EdgarMata/MY-Filamente-Extruder/Eletronics.png

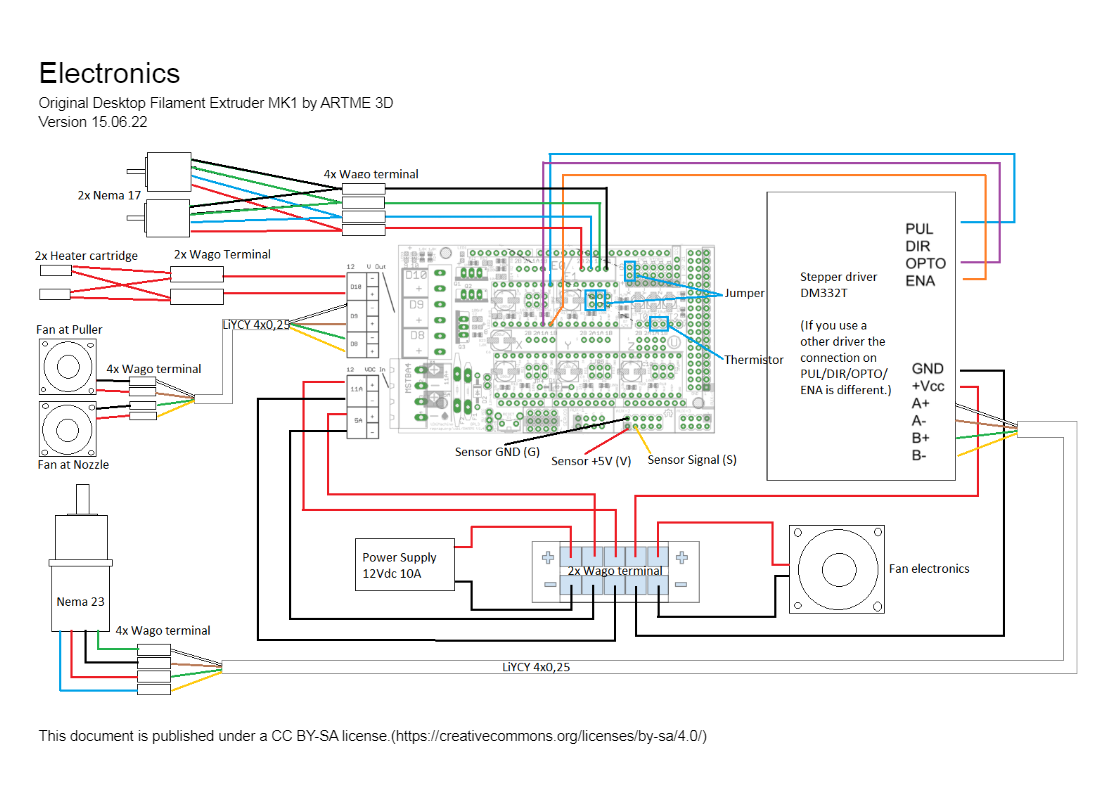
Eletronics.png
