EdgarMata/MY-Filamente-Extruder/Extruder Barrel.png

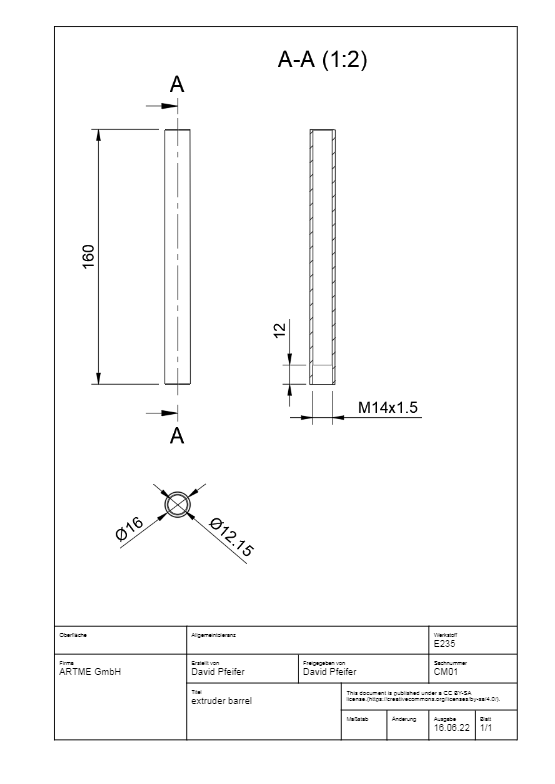
Extruder Barrel.png
