EdgarMata/MY-Filamente-Extruder/01-PartList.png

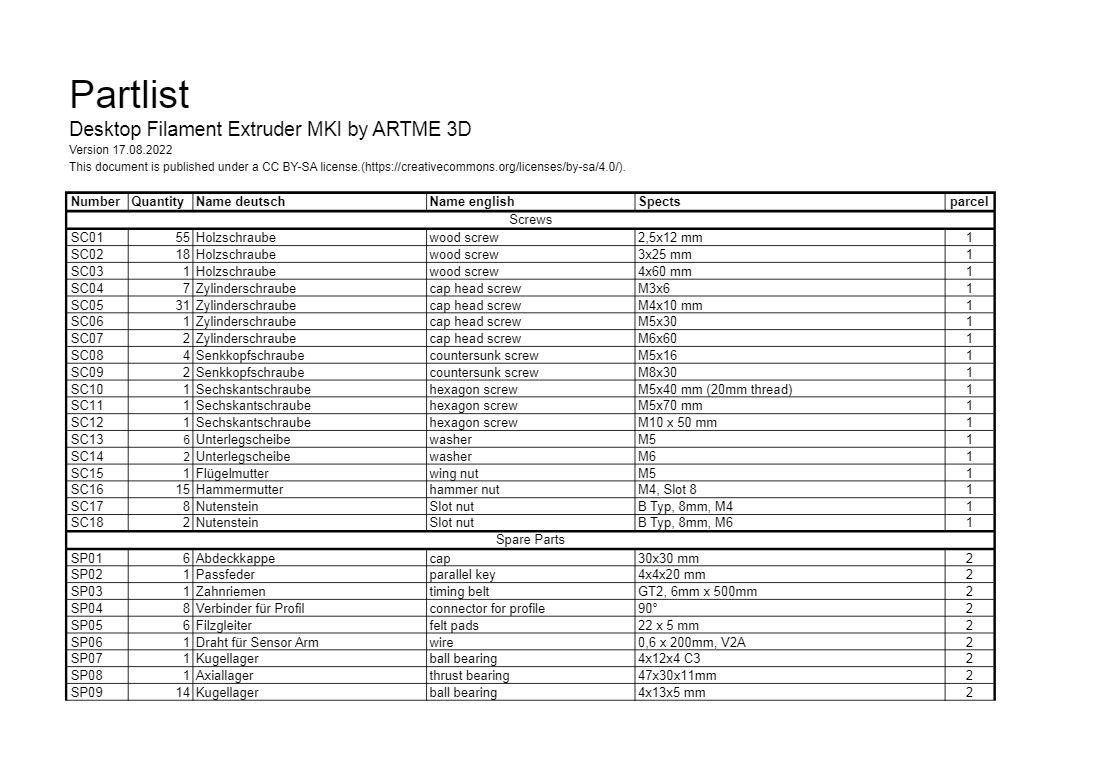
01-PartList.png
