EdgarMata/MY-Filamente-Extruder/02-PartList.png

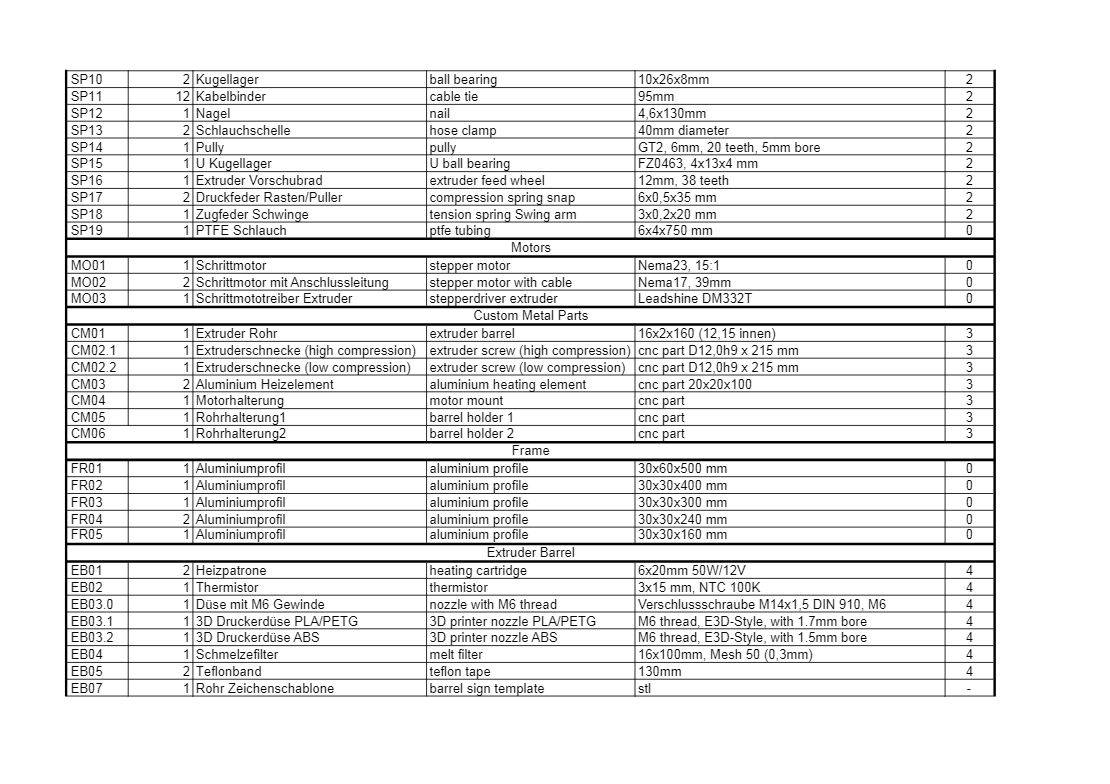
02-PartList.png
