EdgarMata/MY-Filamente-Extruder/03-PartList.png

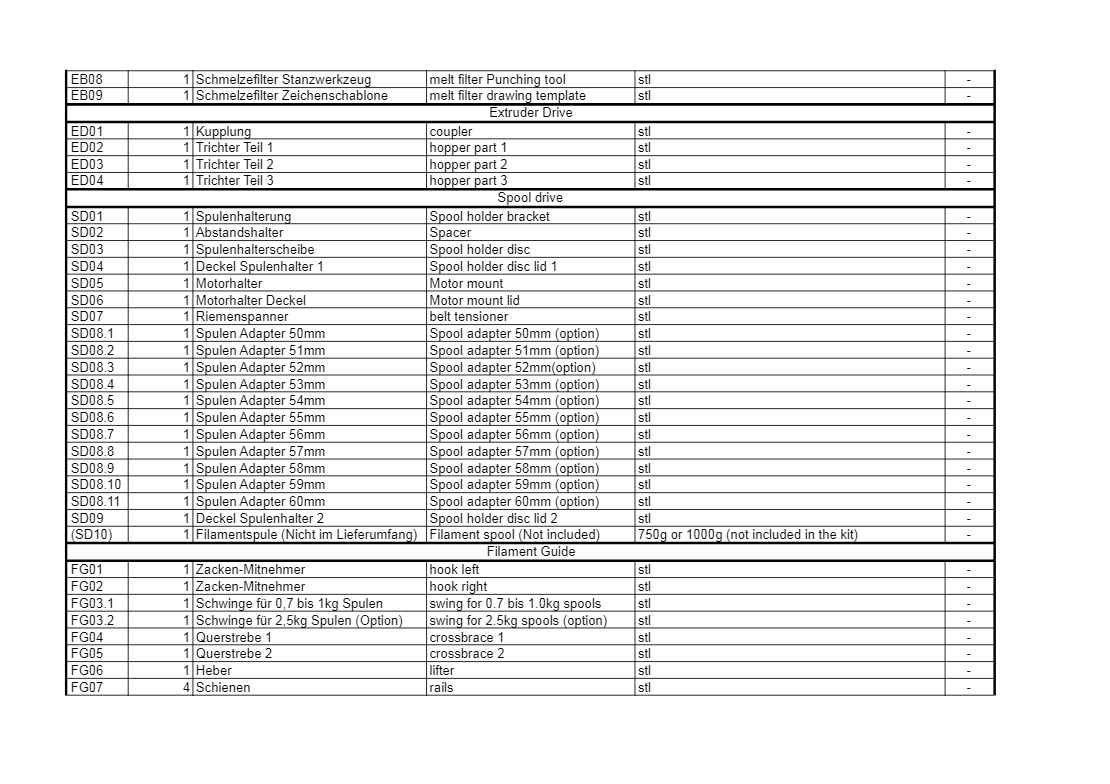
03-PartList.png
