EdgarMata/MY-Filamente-Extruder/04-PartList.png

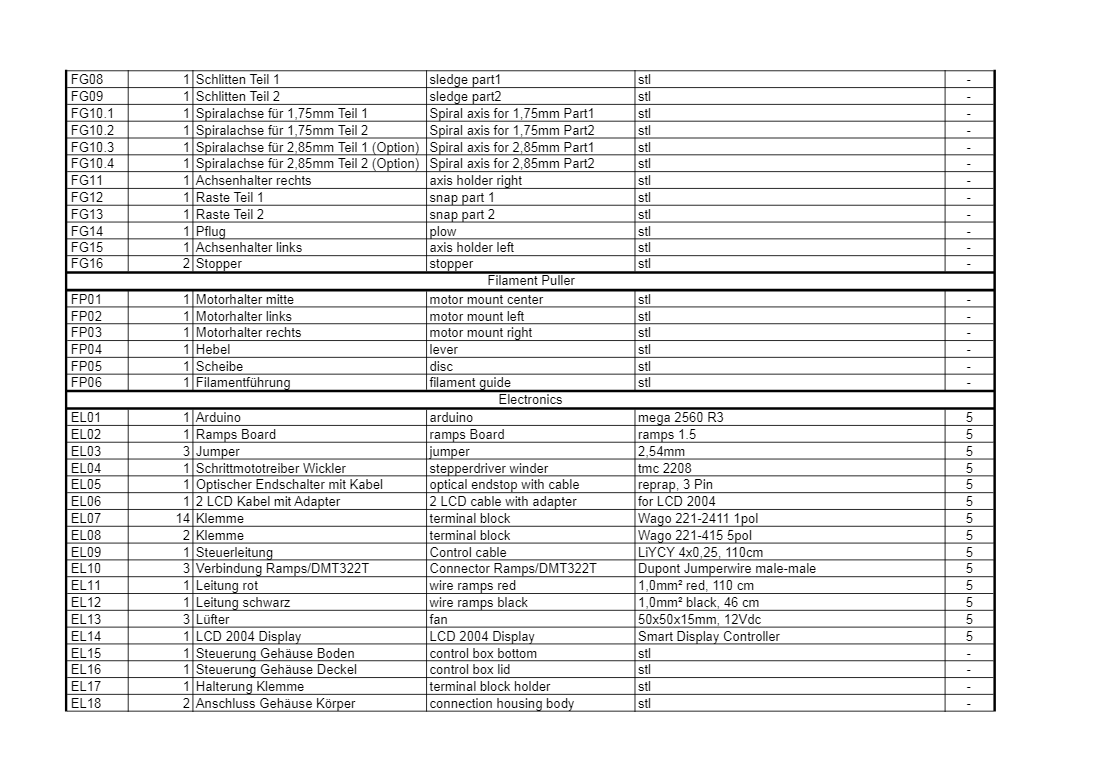
04-PartList.png
