EdgarMata/MY-Filamente-Extruder/05-PartList.png

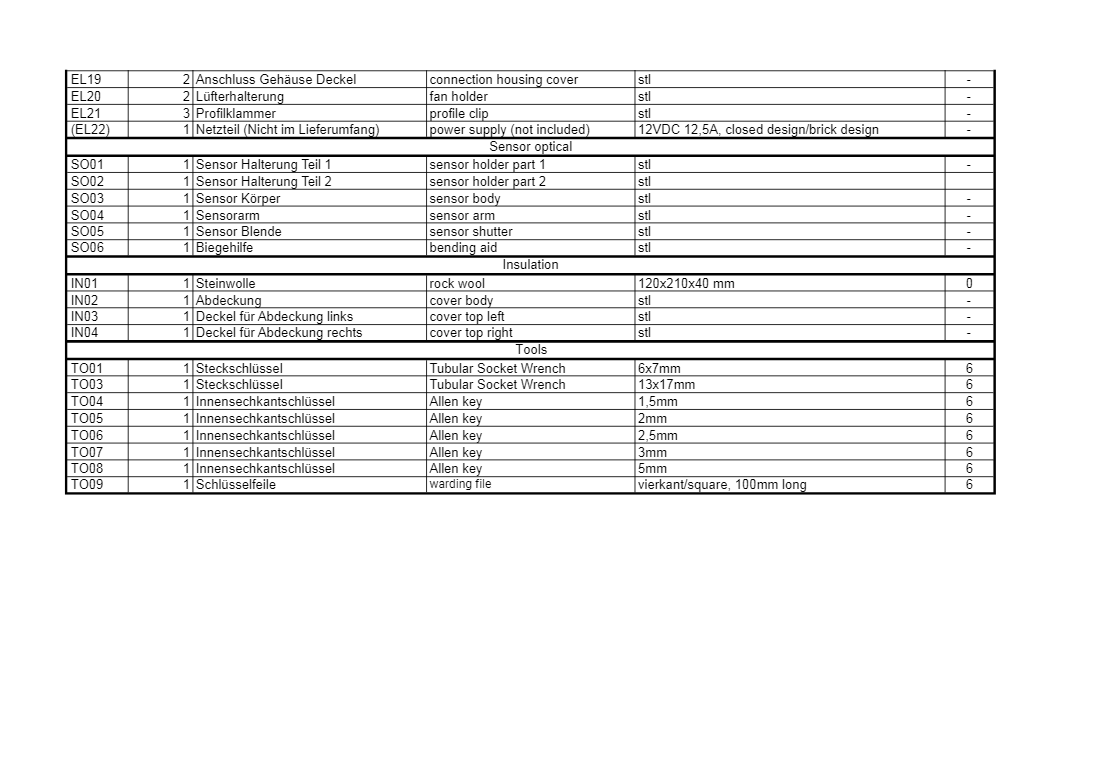
05-PartList.png
