EdgarMata/MY-Filamente-Extruder/05-STL-Dateien-MK1-22-10-26/Electronic (EL)/EL17_terminal block holder.stl

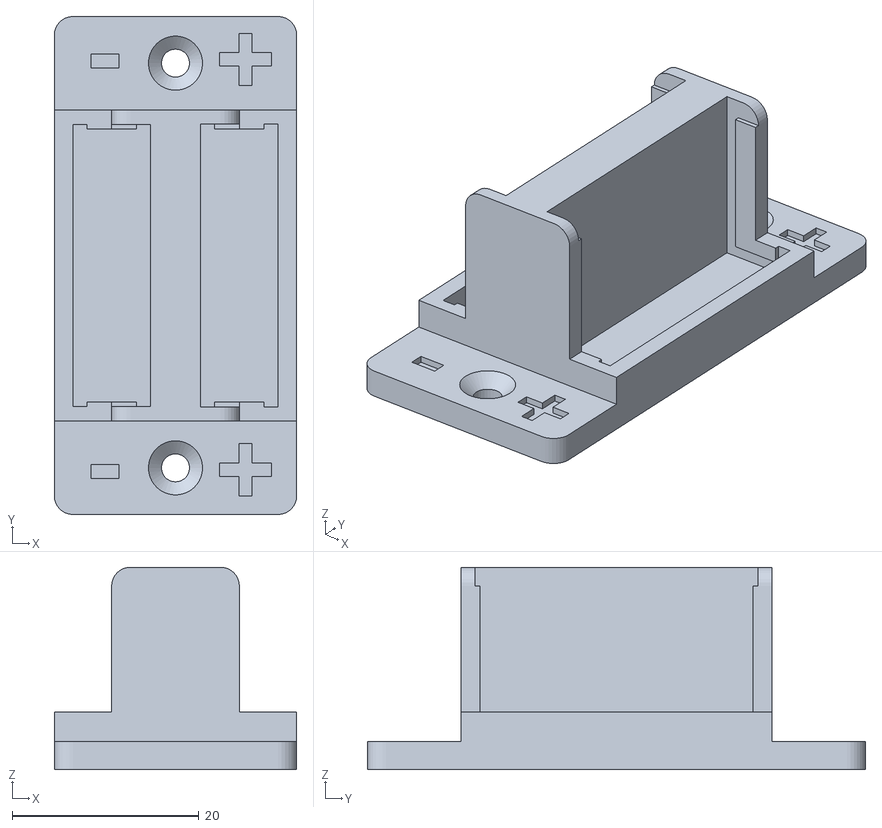
[picture p8: CAD file, 2024-07-03]
05-STL-Dateien-MK1-22-10-26/Electronic (EL)/EL17_terminal block holder.stl
26.0 x 53.4 x 21.7
