EdgarMata/MY-Filamente-Extruder/05-STL-Dateien-MK1-22-10-26/Extruder-Barrel (EB)/EB07-barrel sign template.stl

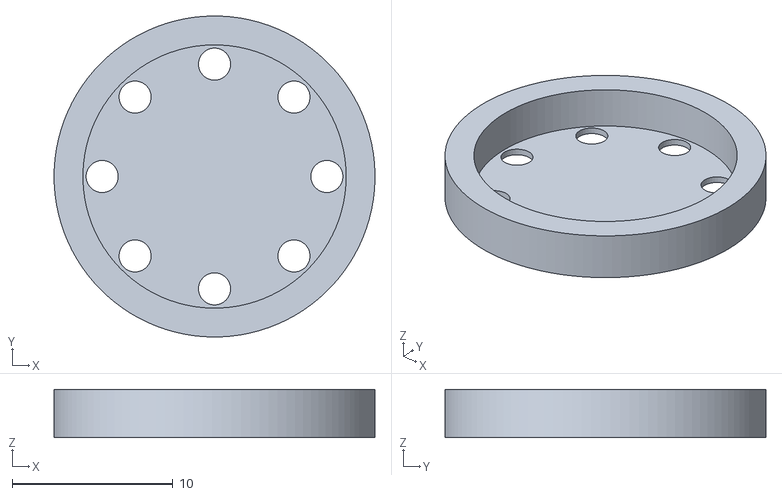
[picture p9: CAD file, 2024-07-03]
05-STL-Dateien-MK1-22-10-26/Extruder-Barrel (EB)/EB07-barrel sign template.stl
20.0 x 20.0 x 3.00
