EdgarMata/MY-Filamente-Extruder/05-STL-Dateien-MK1-22-10-26/Extruder-Drive (ED)/ED03-hopper part2.stl

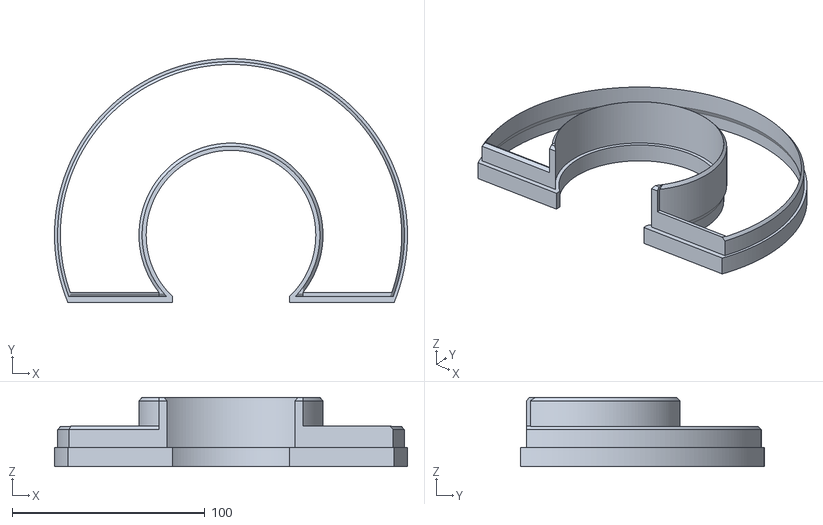
[picture p10: CAD file, 2024-07-03]
05-STL-Dateien-MK1-22-10-26/Extruder-Drive (ED)/ED03-hopper part2.stl
183.2 x 126.5 x 36.0
