EdgarMata/MY-Filamente-Extruder/05-STL-Dateien-MK1-22-10-26/Filament-Guide (FG)/FG09-sledge part2.stl

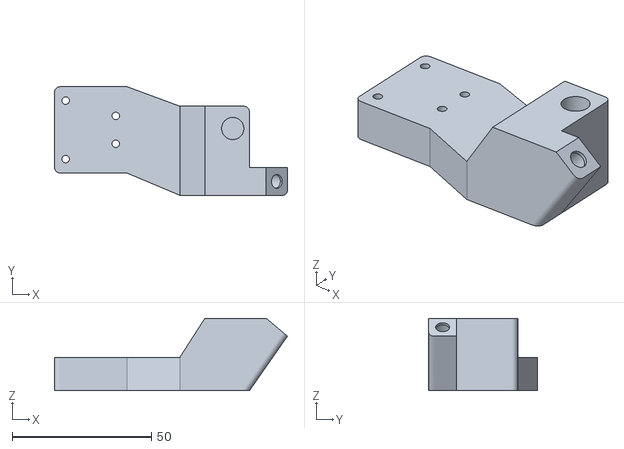
[picture p11: CAD file, 2024-07-03]
05-STL-Dateien-MK1-22-10-26/Filament-Guide (FG)/FG09-sledge part2.stl
83.7 x 39.0 x 26.0
