EdgarMata/MY-Filamente-Extruder/05-STL-Dateien-MK1-22-10-26/Filament-Puller (FP)/FP02-motor mount left.stl

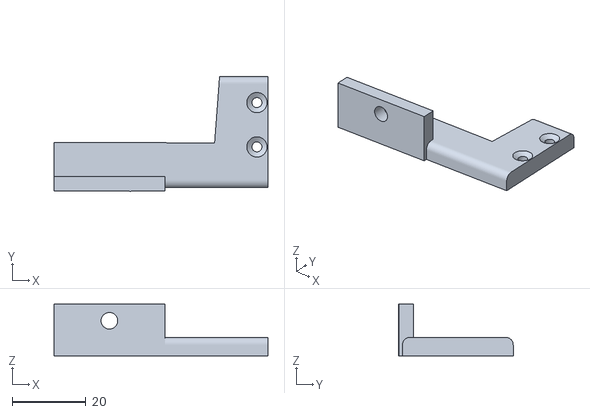
[picture p12: CAD file, 2024-07-03]
05-STL-Dateien-MK1-22-10-26/Filament-Puller (FP)/FP02-motor mount left.stl
57.9 x 31.0 x 14.0
