EdgarMata/MY-Filamente-Extruder/05-STL-Dateien-MK1-22-10-26/Insulation (IN)/IN02_cover body.stl

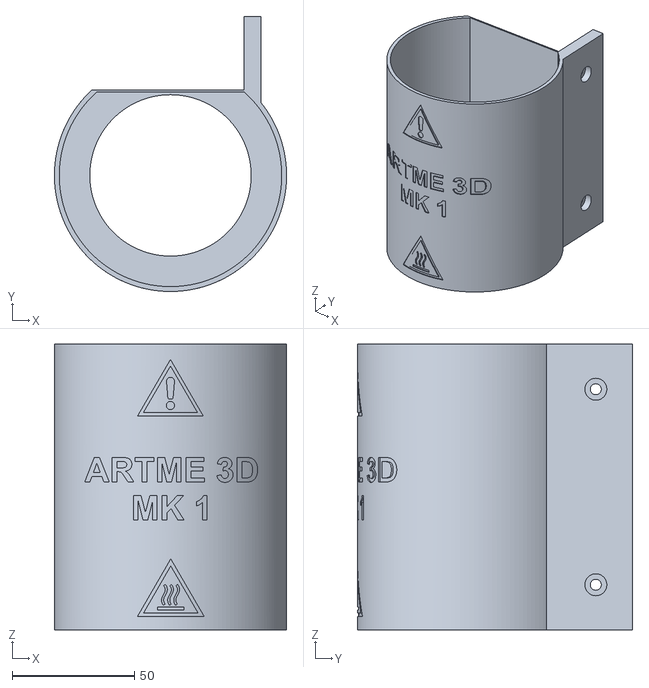
[picture p13: CAD file, 2024-07-03]
05-STL-Dateien-MK1-22-10-26/Insulation (IN)/IN02_cover body.stl
95.0 x 112.5 x 117.0
