EdgarMata/MY-Filamente-Extruder/05-STL-Dateien-MK1-22-10-26/Sensor-Optical (SO)/SO01-sensor holder part 1.stl

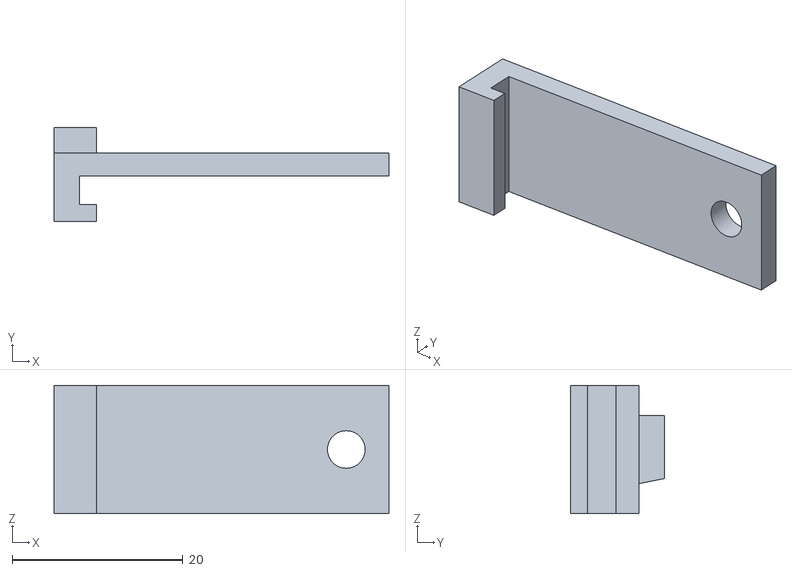
[picture p14: CAD file, 2024-07-03]
05-STL-Dateien-MK1-22-10-26/Sensor-Optical (SO)/SO01-sensor holder part 1.stl
39.2 x 11.0 x 15.0
