EdgarMata/MY-Filamente-Extruder/05-STL-Dateien-MK1-22-10-26/Spool-Drive (SD)/SD07-belt tensioner.stl

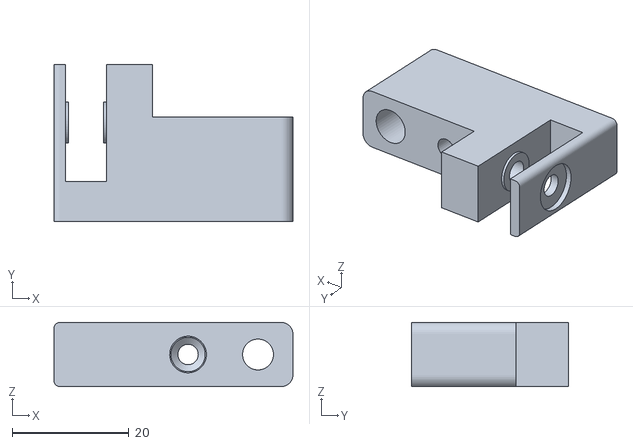
[picture p15: CAD file, 2024-07-03]
05-STL-Dateien-MK1-22-10-26/Spool-Drive (SD)/SD07-belt tensioner.stl
41.0 x 27.0 x 11.0
