EdgarMata/MY-Filamente-Extruder/05-STL-Dateien-MK1-22-10-26/Spool-Drive (SD)/SD08-OPTION-Spool Adapter/SD08.2-Spool adapter 51mm.stl

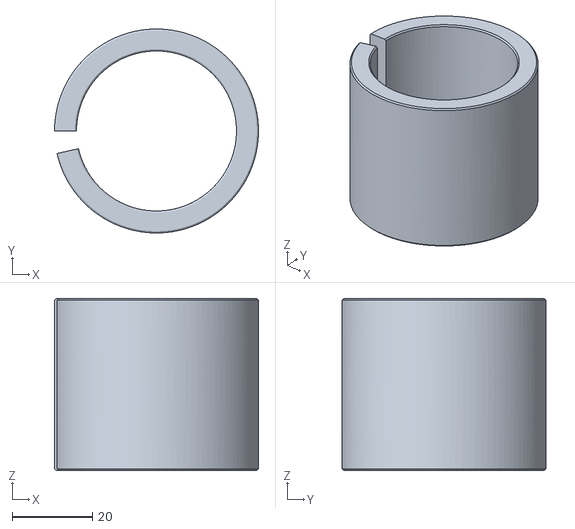
[picture p16: CAD file, 2024-07-03]
05-STL-Dateien-MK1-22-10-26/Spool-Drive (SD)/SD08-OPTION-Spool Adapter/SD08.2-Spool adapter 51mm.stl
51.0 x 51.0 x 43.0
