EdgarMata/MY-Filamente-Extruder/05-STL-Dateien-MK1-22-10-26/Electronic (EL)/EL21-profile clip.stl

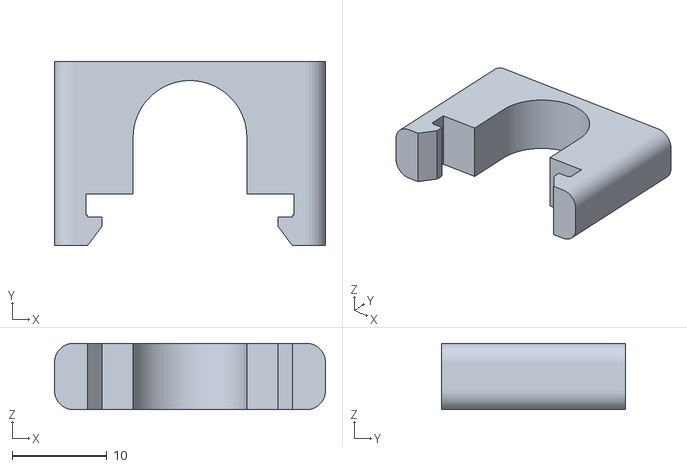
[picture p17: CAD file, 2024-07-03]
05-STL-Dateien-MK1-22-10-26/Electronic (EL)/EL21-profile clip.stl
28.6 x 19.4 x 7.00
