EdgarMata/MY-Filamente-Extruder/05-STL-Dateien-MK1-22-10-26/Extruder-Barrel (EB)/EB08-melt filter Punching tool.stl

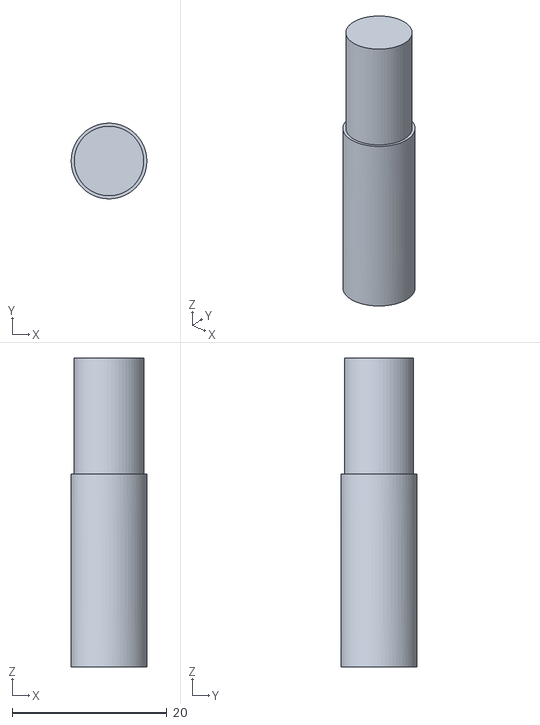
[picture p18: CAD file, 2024-07-03]
05-STL-Dateien-MK1-22-10-26/Extruder-Barrel (EB)/EB08-melt filter Punching tool.stl
9.80 x 9.80 x 40.0
