EdgarMata/MY-Filamente-Extruder/05-STL-Dateien-MK1-22-10-26/Extruder-Drive (ED)/ED01-coupler.stl

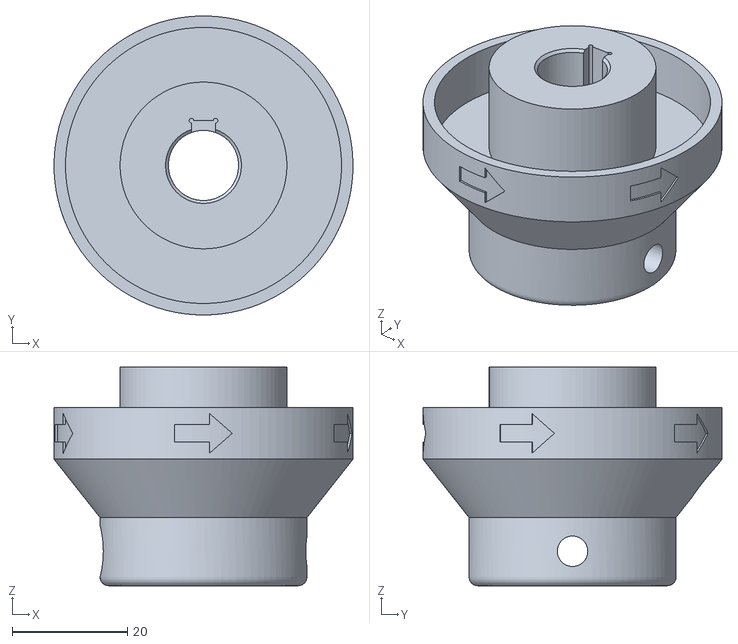
[picture p19: CAD file, 2024-07-03]
05-STL-Dateien-MK1-22-10-26/Extruder-Drive (ED)/ED01-coupler.stl
52.0 x 52.0 x 38.0
