EdgarMata/MY-Filamente-Extruder/05-STL-Dateien-MK1-22-10-26/Filament-Guide (FG)/FG07-rails.stl

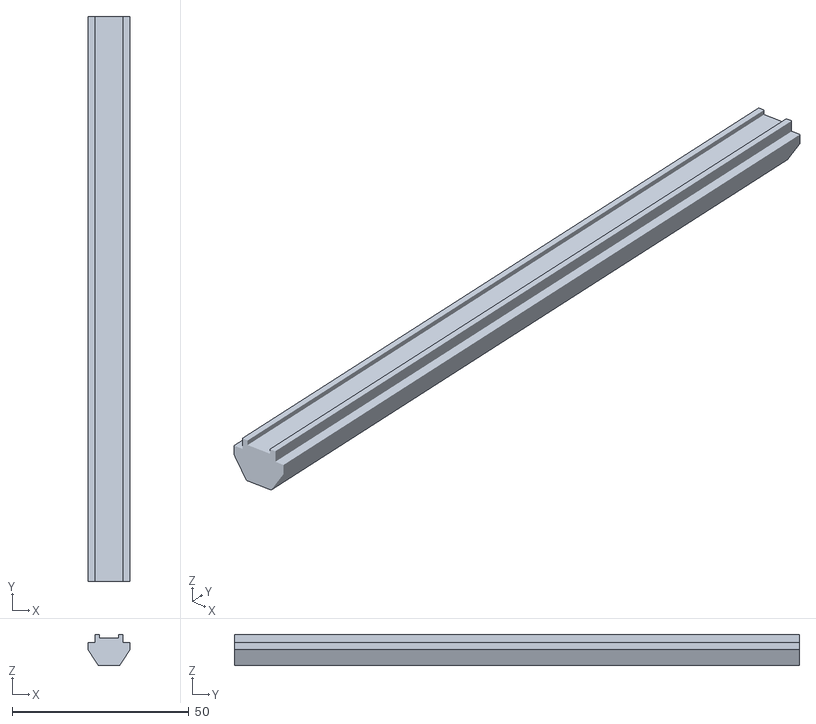
[picture p20: CAD file, 2024-07-03]
05-STL-Dateien-MK1-22-10-26/Filament-Guide (FG)/FG07-rails.stl
12.0 x 160.0 x 8.90
