EdgarMata/MY-Filamente-Extruder/05-STL-Dateien-MK1-22-10-26/Filament-Puller (FP)/FP06-filament guide.stl

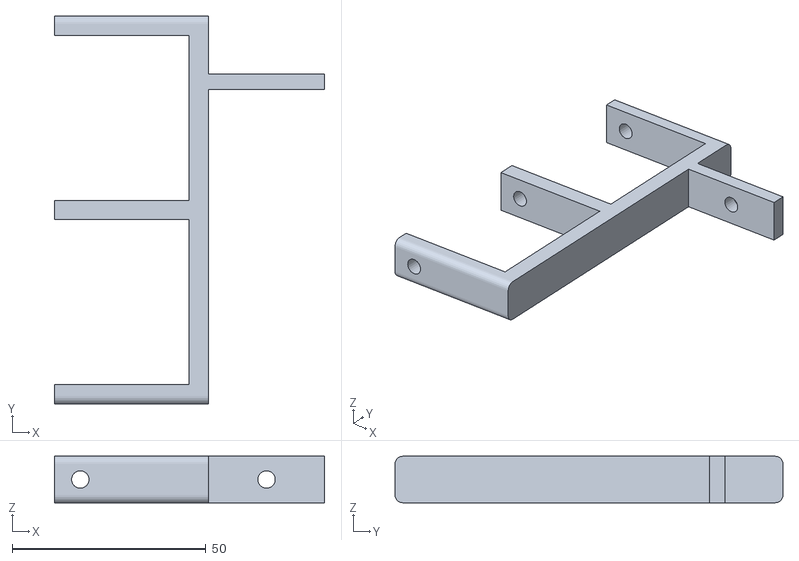
[picture p21: CAD file, 2024-07-03]
05-STL-Dateien-MK1-22-10-26/Filament-Puller (FP)/FP06-filament guide.stl
69.7 x 100.0 x 12.0
