EdgarMata/MY-Filamente-Extruder/05-STL-Dateien-MK1-22-10-26/Insulation (IN)/IN04_cover top right.stl

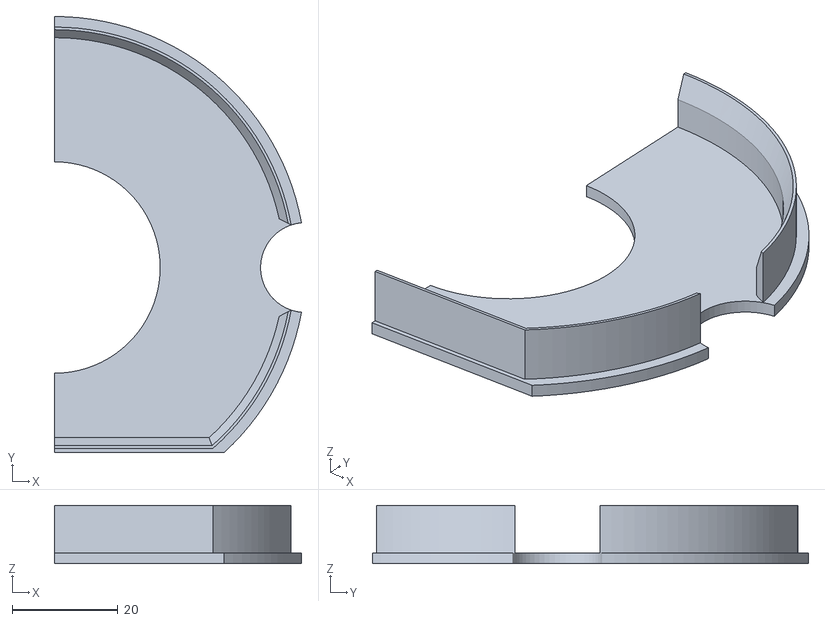
[picture p22: CAD file, 2024-07-03]
05-STL-Dateien-MK1-22-10-26/Insulation (IN)/IN04_cover top right.stl
46.7 x 82.5 x 11.0
