EdgarMata/MY-Filamente-Extruder/05-STL-Dateien-MK1-22-10-26/Sensor-Optical (SO)/SO06-bending aid.stl

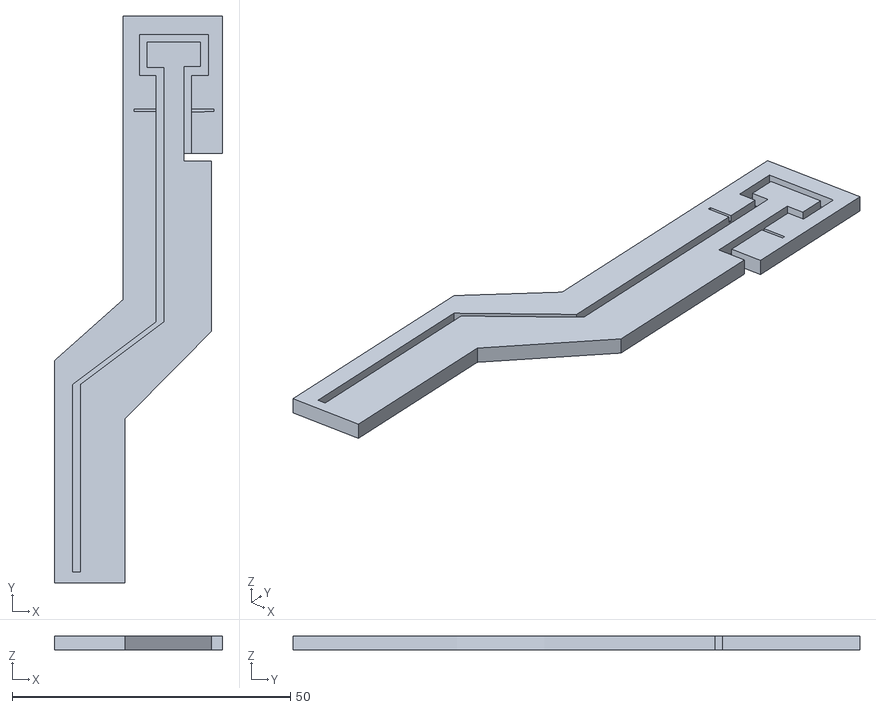
[picture p23: CAD file, 2024-07-03]
05-STL-Dateien-MK1-22-10-26/Sensor-Optical (SO)/SO06-bending aid.stl
30.3 x 102.0 x 2.50
