EdgarMata/MY-Filamente-Extruder/05-STL-Dateien-MK1-22-10-26/Spool-Drive (SD)/SD04-spool holder disc lid 1.stl

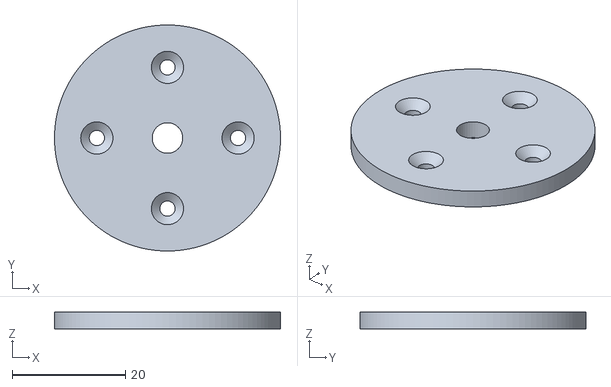
[picture p24: CAD file, 2024-07-03]
05-STL-Dateien-MK1-22-10-26/Spool-Drive (SD)/SD04-spool holder disc lid 1.stl
40.0 x 40.0 x 3.00
