EdgarMata/MY-Filamente-Extruder/05-STL-Dateien-MK1-22-10-26/Spool-Drive (SD)/SD08-OPTION-Spool Adapter/SD08.3-Spool adapter 52mm.stl

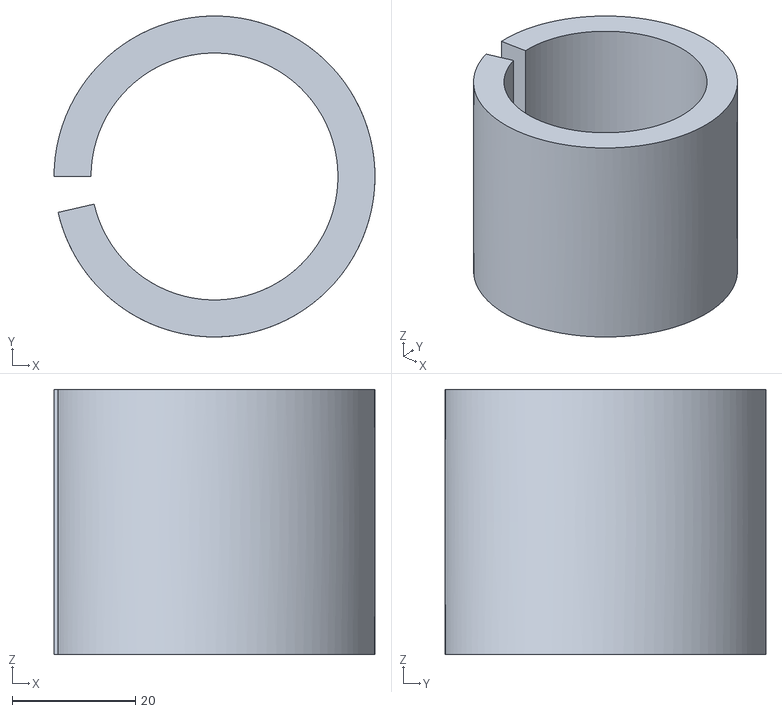
[picture p25: CAD file, 2024-07-03]
05-STL-Dateien-MK1-22-10-26/Spool-Drive (SD)/SD08-OPTION-Spool Adapter/SD08.3-Spool adapter 52mm.stl
52.0 x 52.0 x 43.0
