EdgarMata/MY-Filamente-Extruder/05-STL-Dateien-MK1-22-10-26/Electronic (EL)/EL19-connection housing cover.stl

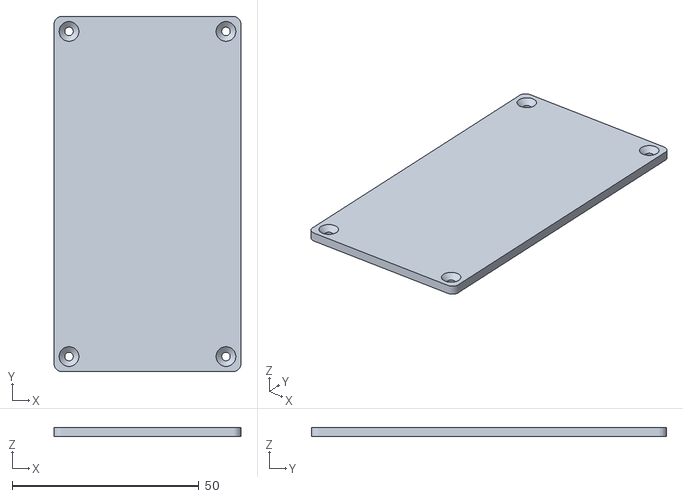
[picture p26: CAD file, 2024-07-03]
05-STL-Dateien-MK1-22-10-26/Electronic (EL)/EL19-connection housing cover.stl
50.0 x 95.0 x 2.50
