EdgarMata/MY-Filamente-Extruder/05-STL-Dateien-MK1-22-10-26/Extruder-Barrel (EB)/EB09-melt filter drawing template.stl

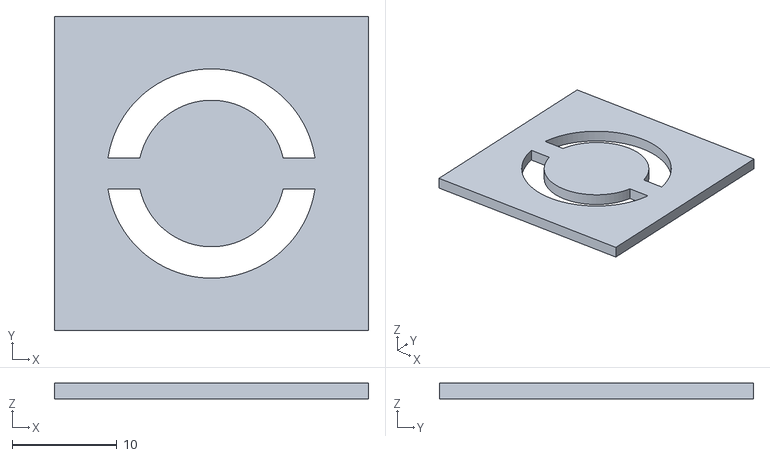
[picture p27: CAD file, 2024-07-03]
05-STL-Dateien-MK1-22-10-26/Extruder-Barrel (EB)/EB09-melt filter drawing template.stl
30.0 x 30.0 x 1.50
