EdgarMata/MY-Filamente-Extruder/05-STL-Dateien-MK1-22-10-26/Extruder-Drive (ED)/ED04-hopper part 3.stl

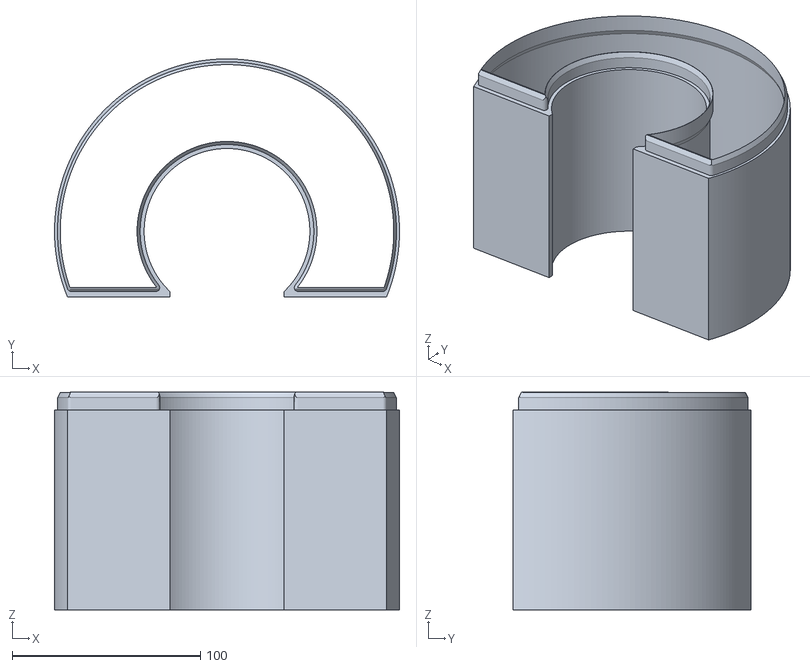
[picture p28: CAD file, 2024-07-03]
05-STL-Dateien-MK1-22-10-26/Extruder-Drive (ED)/ED04-hopper part 3.stl
183.2 x 126.5 x 115.5
