EdgarMata/MY-Filamente-Extruder/05-STL-Dateien-MK1-22-10-26/Filament-Guide (FG)/FG08-sledge part1.stl

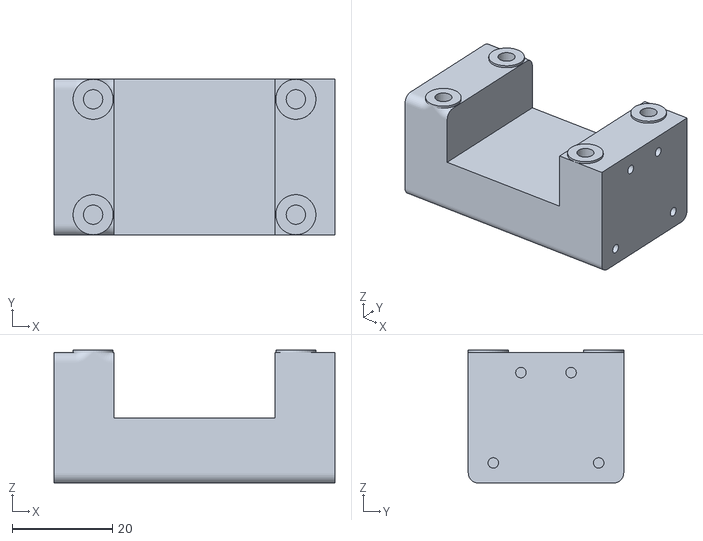
[picture p29: CAD file, 2024-07-03]
05-STL-Dateien-MK1-22-10-26/Filament-Guide (FG)/FG08-sledge part1.stl
56.0 x 31.0 x 26.5
