EdgarMata/MY-Filamente-Extruder/05-STL-Dateien-MK1-22-10-26/Filament-Puller (FP)/FP04-lever.stl

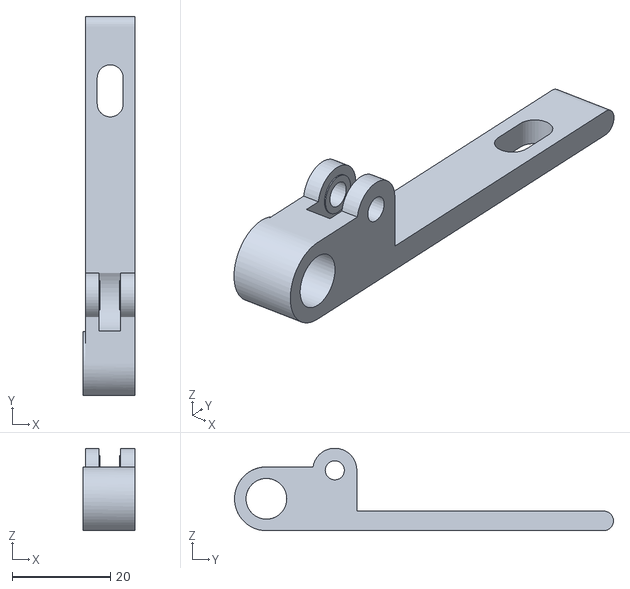
[picture p30: CAD file, 2024-07-03]
05-STL-Dateien-MK1-22-10-26/Filament-Puller (FP)/FP04-lever.stl
10.5 x 77.2 x 16.8
