EdgarMata/MY-Filamente-Extruder/05-STL-Dateien-MK1-22-10-26/Insulation (IN)/IN03_cover top left.stl

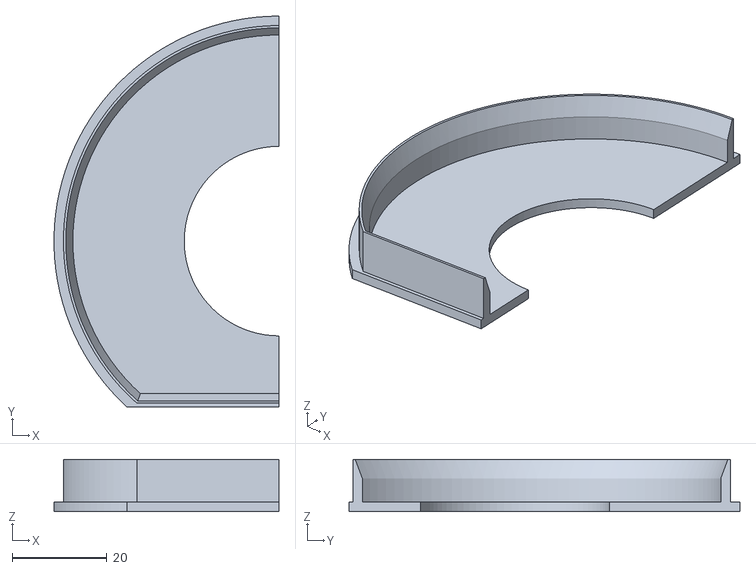
[picture p31: CAD file, 2024-07-03]
05-STL-Dateien-MK1-22-10-26/Insulation (IN)/IN03_cover top left.stl
47.5 x 82.5 x 11.0
