EdgarMata/MY-Filamente-Extruder/05-STL-Dateien-MK1-22-10-26/Sensor-Optical (SO)/SO03-sensor body.stl

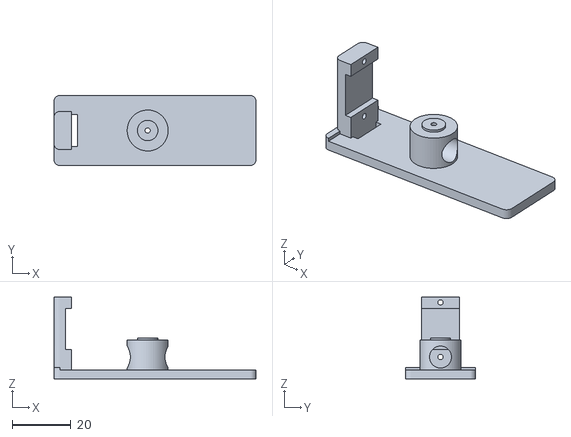
[picture p32: CAD file, 2024-07-03]
05-STL-Dateien-MK1-22-10-26/Sensor-Optical (SO)/SO03-sensor body.stl
69.0 x 24.0 x 28.0
