EdgarMata/MY-Filamente-Extruder/05-STL-Dateien-MK1-22-10-26/Spool-Drive (SD)/SD01-spool holder bracket.stl

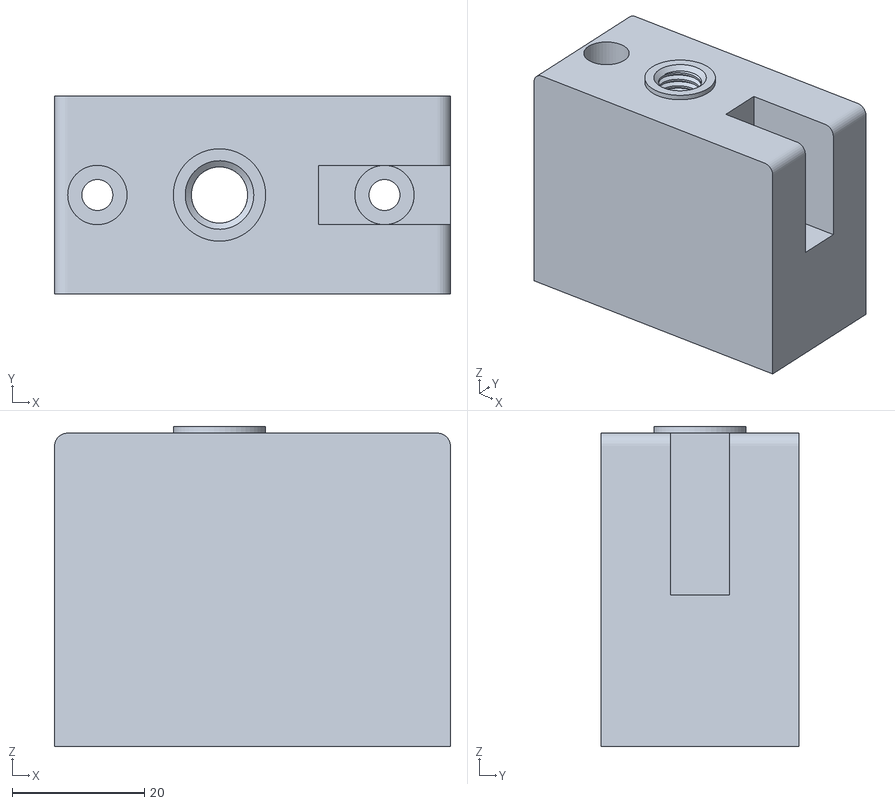
[picture p33: CAD file, 2024-07-03]
05-STL-Dateien-MK1-22-10-26/Spool-Drive (SD)/SD01-spool holder bracket.stl
60.0 x 30.0 x 48.5
