EdgarMata/MY-Filamente-Extruder/05-STL-Dateien-MK1-22-10-26/Spool-Drive (SD)/SD08-OPTION-Spool Adapter/SD08.6-Spool adapter 55mm.stl

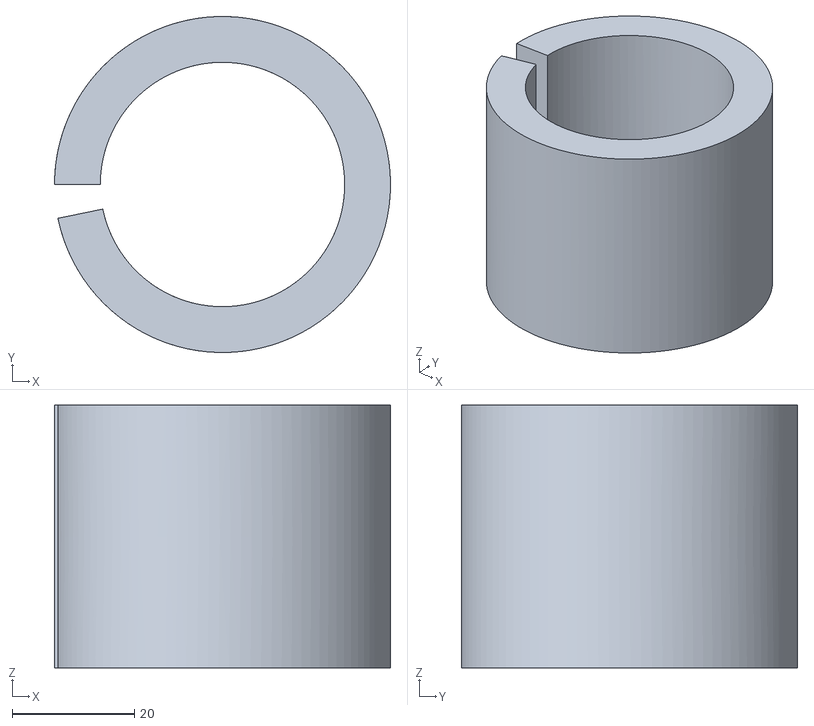
[picture p34: CAD file, 2024-07-03]
05-STL-Dateien-MK1-22-10-26/Spool-Drive (SD)/SD08-OPTION-Spool Adapter/SD08.6-Spool adapter 55mm.stl
55.0 x 55.0 x 43.0
