EdgarMata/MY-Filamente-Extruder/05-STL-Dateien-MK1-22-10-26/Electronic (EL)/EL20-fan holder.stl

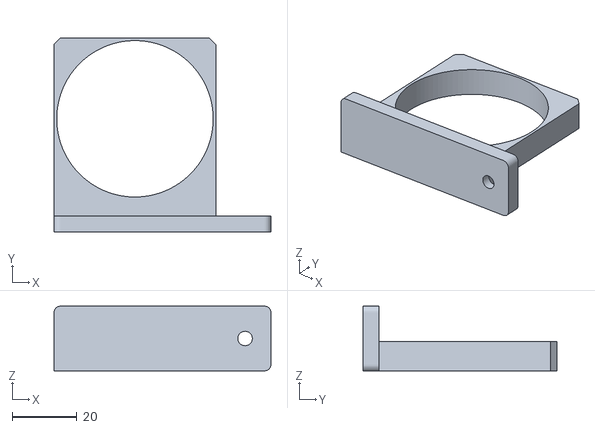
[picture p35: CAD file, 2024-07-03]
05-STL-Dateien-MK1-22-10-26/Electronic (EL)/EL20-fan holder.stl
67.0 x 60.0 x 20.0
