EdgarMata/MY-Filamente-Extruder/05-STL-Dateien-MK1-22-10-26/Extruder-Drive (ED)/ED02-hopper part1.stl

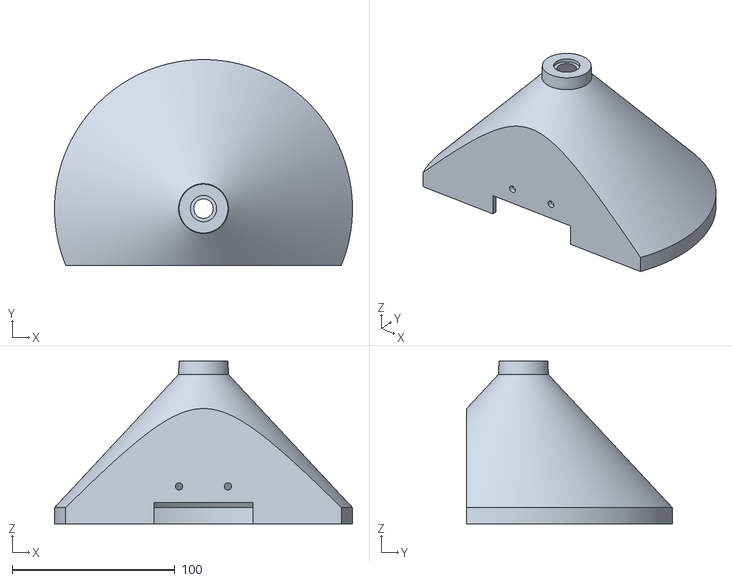
[picture p36: CAD file, 2024-07-03]
05-STL-Dateien-MK1-22-10-26/Extruder-Drive (ED)/ED02-hopper part1.stl
183.2 x 126.5 x 100.0
