EdgarMata/MY-Filamente-Extruder/05-STL-Dateien-MK1-22-10-26/Filament-Guide (FG)/FG13-snap part 2.stl

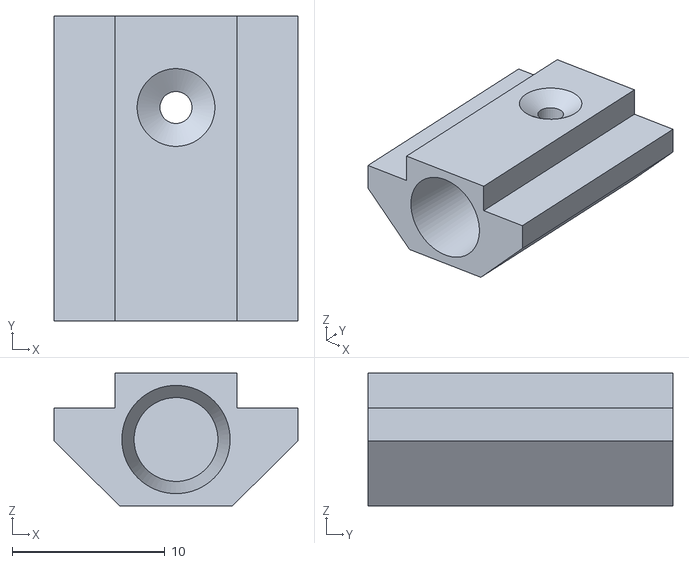
[picture p37: CAD file, 2024-07-03]
05-STL-Dateien-MK1-22-10-26/Filament-Guide (FG)/FG13-snap part 2.stl
16.0 x 20.0 x 8.70
