EdgarMata/MY-Filamente-Extruder/05-STL-Dateien-MK1-22-10-26/Filament-Puller (FP)/FP01-motor mount center.stl

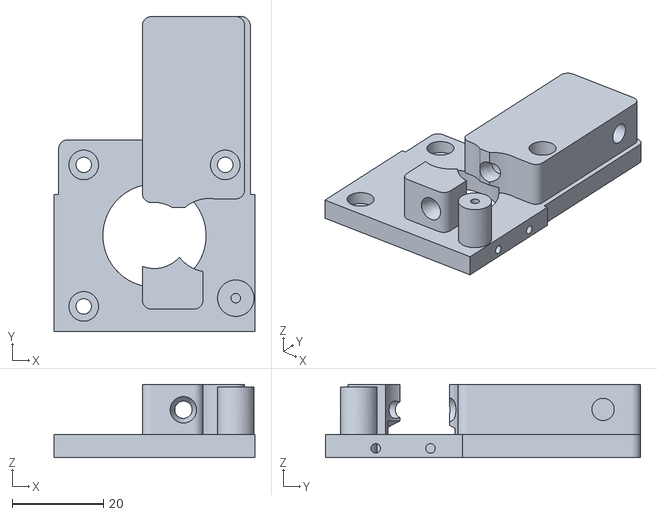
[picture p38: CAD file, 2024-07-03]
05-STL-Dateien-MK1-22-10-26/Filament-Puller (FP)/FP01-motor mount center.stl
44.0 x 69.0 x 16.0
