EdgarMata/MY-Filamente-Extruder/05-STL-Dateien-MK1-22-10-26/Sensor-Optical (SO)/SO05-sensor shutter.stl

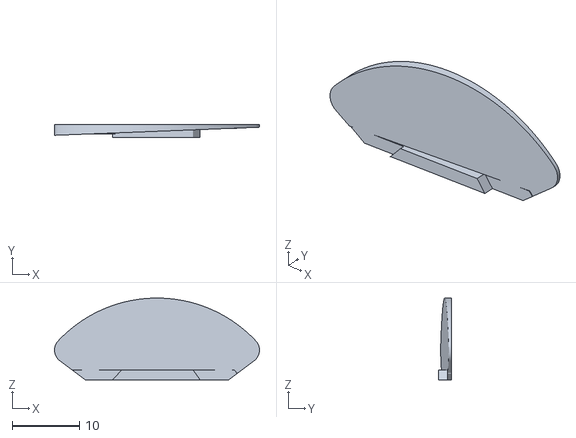
[picture p39: CAD file, 2024-07-03]
05-STL-Dateien-MK1-22-10-26/Sensor-Optical (SO)/SO05-sensor shutter.stl
30.6 x 2.00 x 12.2
