EdgarMata/MY-Filamente-Extruder/05-STL-Dateien-MK1-22-10-26/Spool-Drive (SD)/SD08-OPTION-Spool Adapter/SD08.8-Spool adapter 57mm.stl

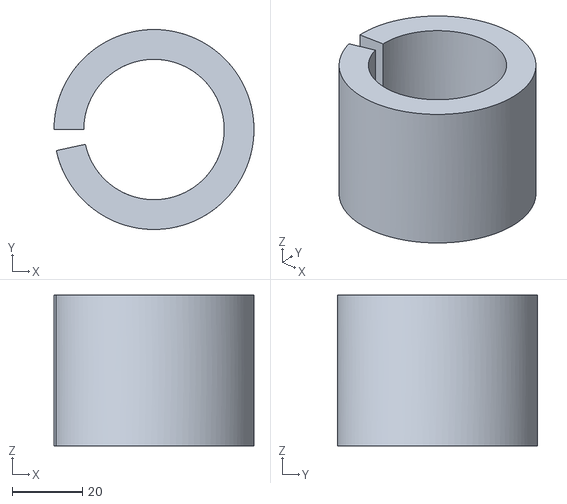
[picture p41: CAD file, 2024-07-03]
05-STL-Dateien-MK1-22-10-26/Spool-Drive (SD)/SD08-OPTION-Spool Adapter/SD08.8-Spool adapter 57mm.stl
57.0 x 57.0 x 43.0
