EdgarMata/MY-Filamente-Extruder/05-STL-Dateien-MK1-22-10-26/Electronic (EL)/EL15-control box bottom.stl

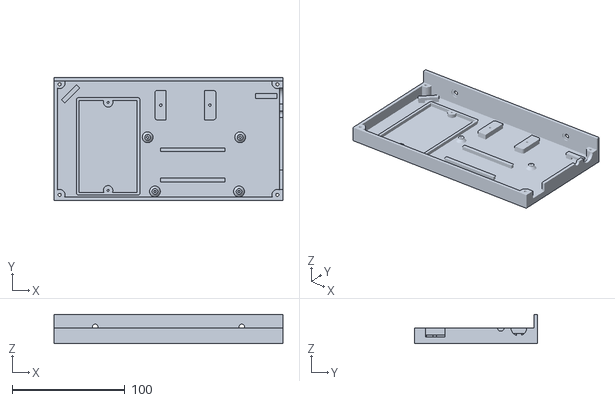
[picture p42: CAD file, 2024-07-03]
05-STL-Dateien-MK1-22-10-26/Electronic (EL)/EL15-control box bottom.stl
203.0 x 109.0 x 26.0
