EdgarMata/MY-Filamente-Extruder/05-STL-Dateien-MK1-22-10-26/Filament-Guide (FG)/FG04-crossbrace 1.stl

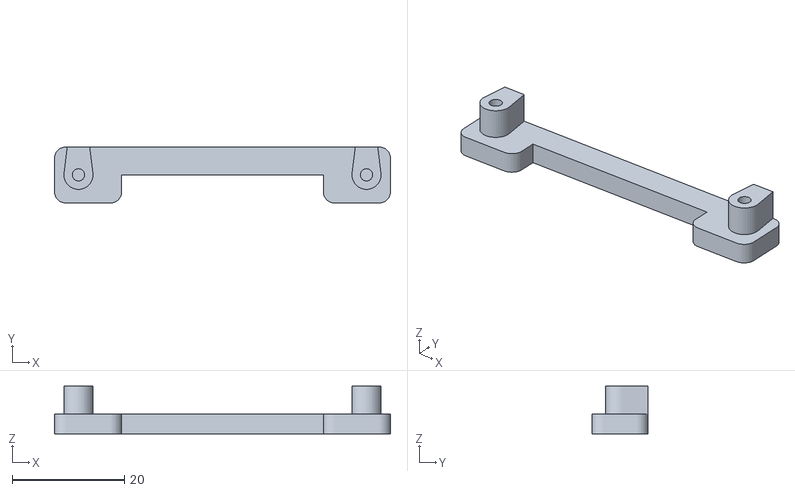
[picture p43: CAD file, 2024-07-03]
05-STL-Dateien-MK1-22-10-26/Filament-Guide (FG)/FG04-crossbrace 1.stl
60.0 x 10.0 x 8.50
