EdgarMata/MY-Filamente-Extruder/05-STL-Dateien-MK1-22-10-26/Filament-Puller (FP)/FP05-disc.stl

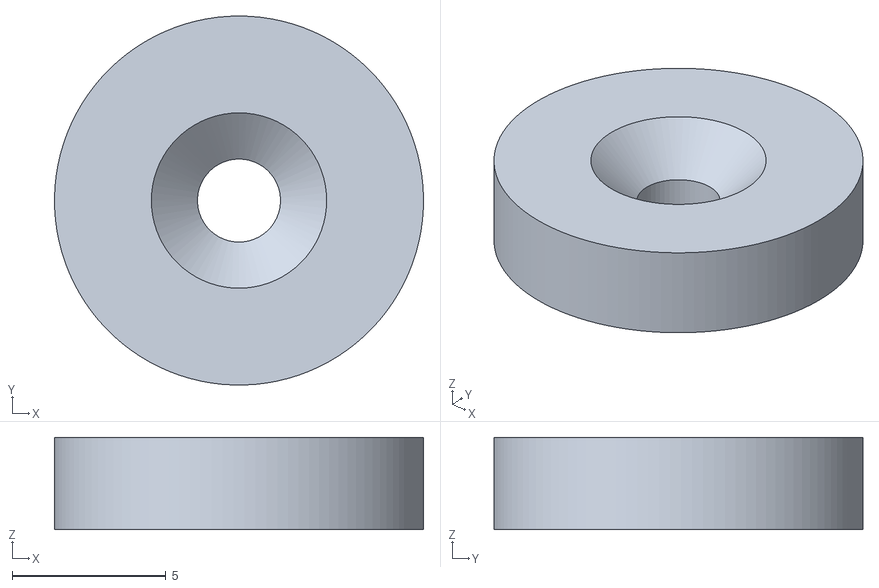
[picture p44: CAD file, 2024-07-03]
05-STL-Dateien-MK1-22-10-26/Filament-Puller (FP)/FP05-disc.stl
12.0 x 12.0 x 3.00
