EdgarMata/MY-Filamente-Extruder/05-STL-Dateien-MK1-22-10-26/Sensor-Optical (SO)/SO04-sensor arm.stl

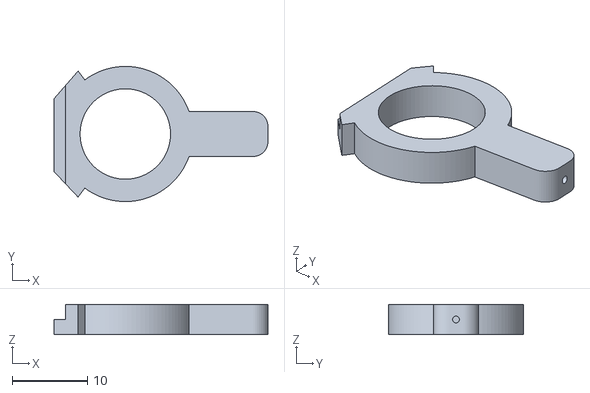
[picture p45: CAD file, 2024-07-03]
05-STL-Dateien-MK1-22-10-26/Sensor-Optical (SO)/SO04-sensor arm.stl
28.5 x 18.0 x 4.00
