EdgarMata/MY-Filamente-Extruder/05-STL-Dateien-MK1-22-10-26/Spool-Drive (SD)/SD03-Spool holder disc.stl

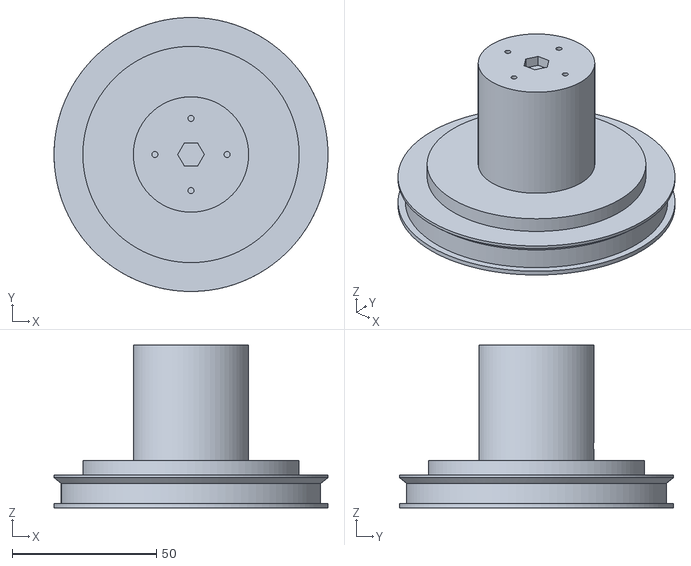
[picture p46: CAD file, 2024-07-03]
05-STL-Dateien-MK1-22-10-26/Spool-Drive (SD)/SD03-Spool holder disc.stl
95.0 x 95.0 x 56.5
