EdgarMata/MY-Filamente-Extruder/05-STL-Dateien-MK1-22-10-26/Spool-Drive (SD)/SD08-OPTION-Spool Adapter/SD08.10-Spool adapter 59mm.stl

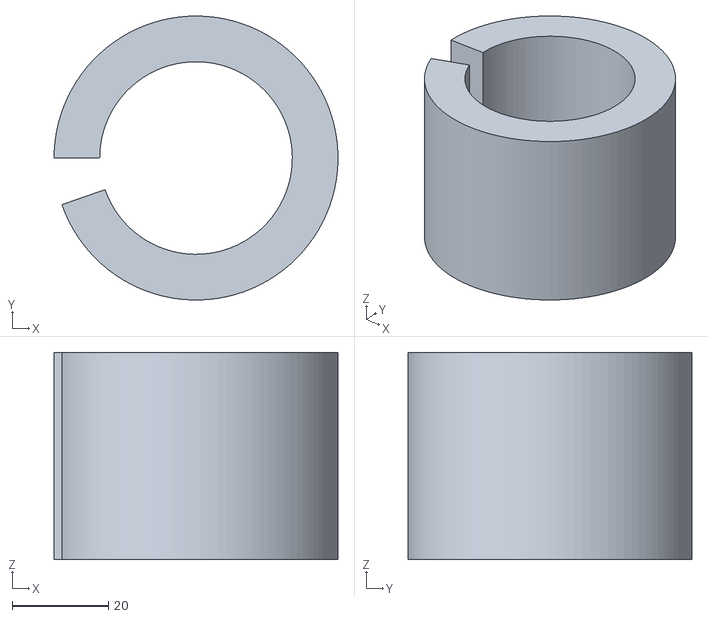
[picture p47: CAD file, 2024-07-03]
05-STL-Dateien-MK1-22-10-26/Spool-Drive (SD)/SD08-OPTION-Spool Adapter/SD08.10-Spool adapter 59mm.stl
59.0 x 59.0 x 43.0
