EdgarMata/MY-Filamente-Extruder/05-STL-Dateien-MK1-22-10-26/Electronic (EL)/EL16-control box lid.stl

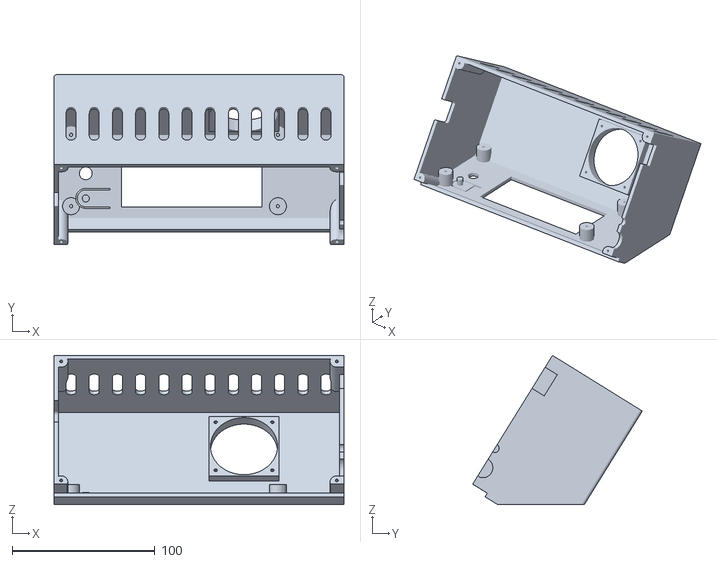
[picture p48: CAD file, 2024-07-03]
05-STL-Dateien-MK1-22-10-26/Electronic (EL)/EL16-control box lid.stl
203.0 x 118.8 x 104.5
