EdgarMata/MY-Filamente-Extruder/05-STL-Dateien-MK1-22-10-26/Sensor-Optical (SO)/SO02-sensor holder part 2.stl

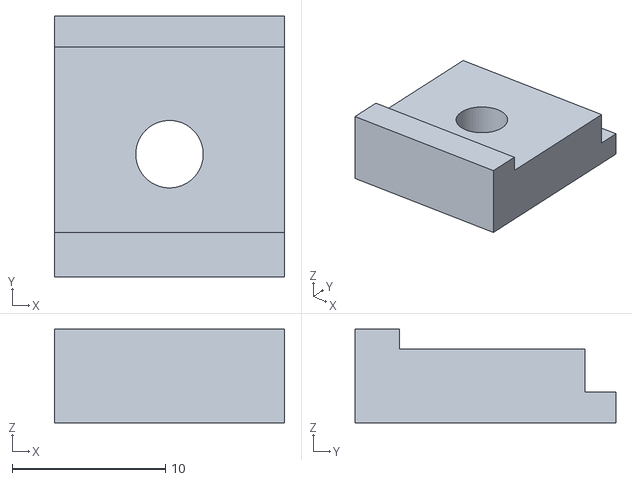
[picture p51: CAD file, 2024-07-03]
05-STL-Dateien-MK1-22-10-26/Sensor-Optical (SO)/SO02-sensor holder part 2.stl
15.0 x 17.0 x 6.10
