EdgarMata/MY-Filamente-Extruder/05-STL-Dateien-MK1-22-10-26/Spool-Drive (SD)/SD06-motor mount lid.stl

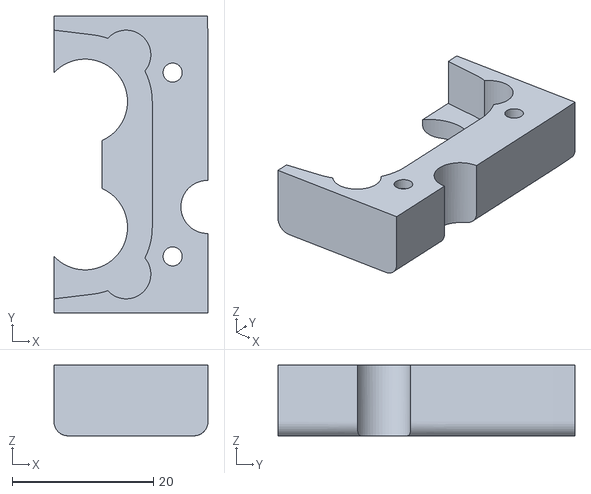
[picture p52: CAD file, 2024-07-03]
05-STL-Dateien-MK1-22-10-26/Spool-Drive (SD)/SD06-motor mount lid.stl
21.8 x 42.0 x 10.0
