EdgarMata/MY-Filamente-Extruder/05-STL-Dateien-MK1-22-10-26/Electronic (EL)/EL18-connection housing body.stl

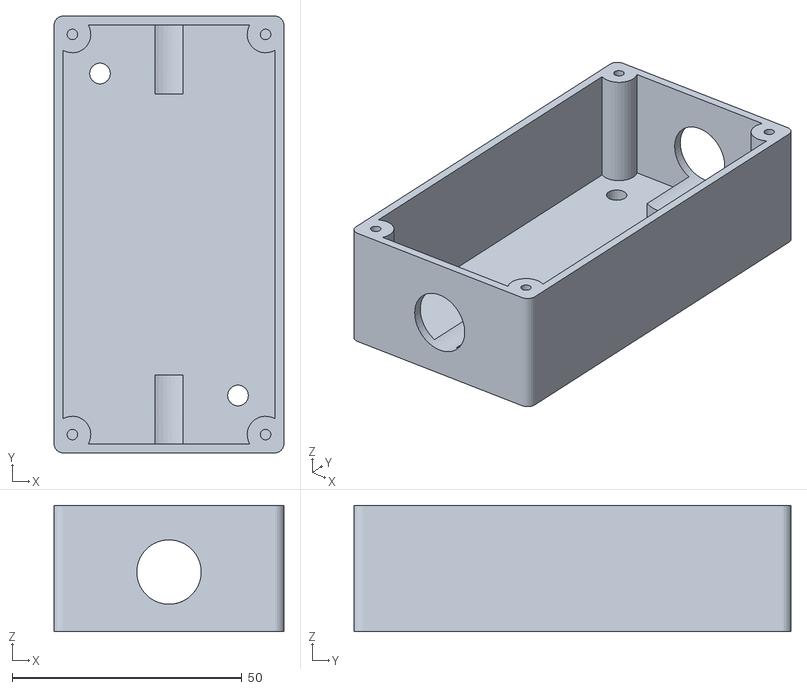
[picture p54: CAD file, 2024-07-03]
05-STL-Dateien-MK1-22-10-26/Electronic (EL)/EL18-connection housing body.stl
50.0 x 95.0 x 27.5
