EdgarMata/MY-Filamente-Extruder/05-STL-Dateien-MK1-22-10-26/Spool-Drive (SD)/SD09-spool holder disc lid 2.stl

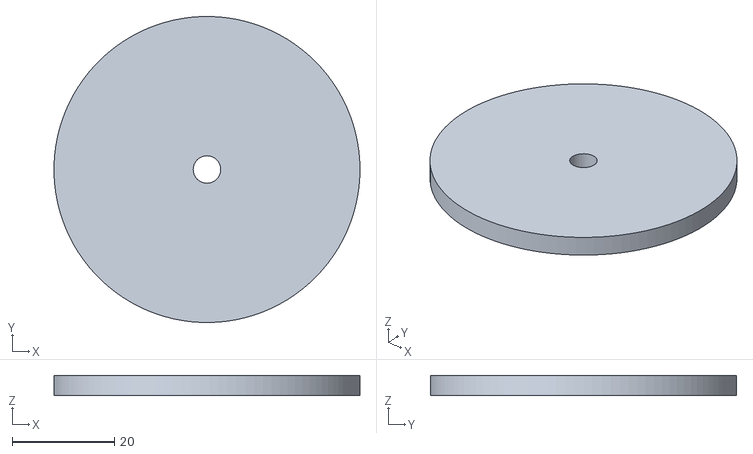
[picture p57: CAD file, 2024-07-03]
05-STL-Dateien-MK1-22-10-26/Spool-Drive (SD)/SD09-spool holder disc lid 2.stl
60.0 x 60.0 x 4.00
