EdgarMata/MY-Filamente-Extruder/05-STL-Dateien-MK1-22-10-26/Filament-Guide (FG)/FG03.1-swing for 0.7 bis 1.0kg spools.stl

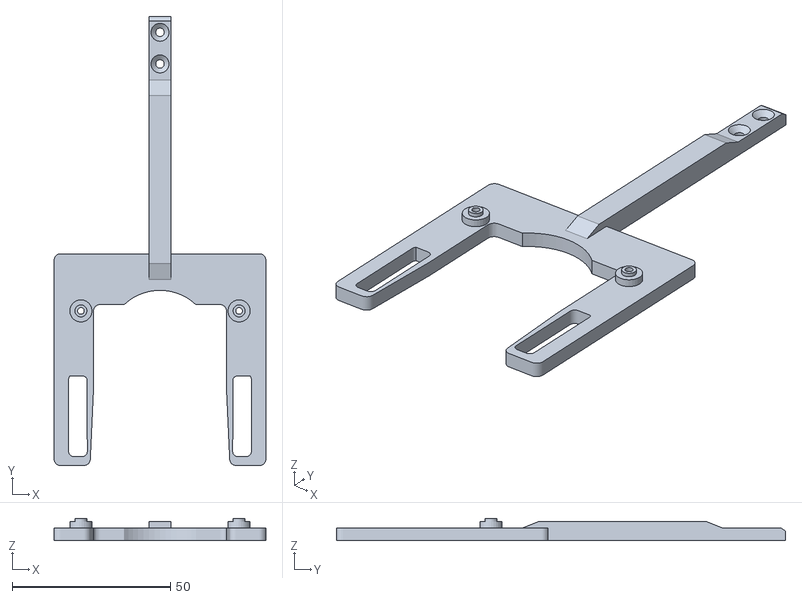
[picture p58: CAD file, 2024-07-03]
05-STL-Dateien-MK1-22-10-26/Filament-Guide (FG)/FG03.1-swing for 0.7 bis 1.0kg spools.stl
67.0 x 141.9 x 7.00
