EdgarMata/MY-Filamente-Extruder/05-STL-Dateien-MK1-22-10-26/Filament-Guide (FG)/FG05-crossbrace 2.stl

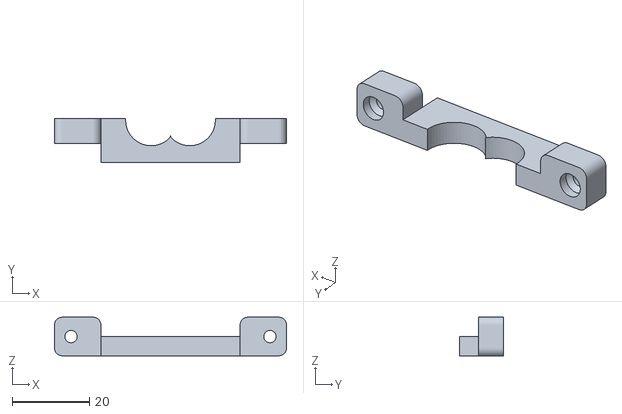
[picture p68: CAD file, 2024-07-03]
05-STL-Dateien-MK1-22-10-26/Filament-Guide (FG)/FG05-crossbrace 2.stl
60.0 x 11.5 x 10.0
