EdgarMata/MY-Filamente-Extruder/05-STL-Dateien-MK1-22-10-26/Filament-Guide (FG)/FG03.2-swing for 2.5kg spools (option).stl

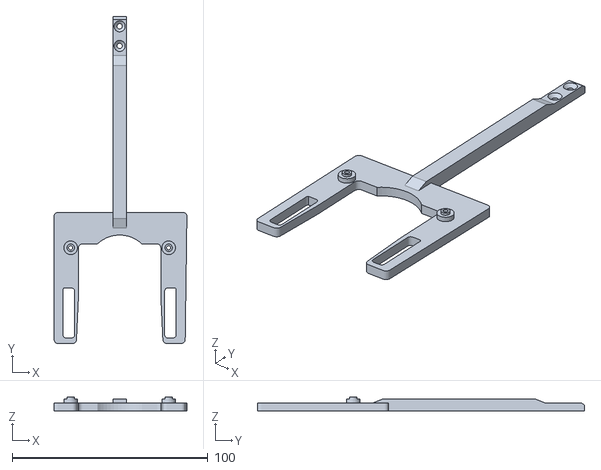
[picture p70: CAD file, 2024-07-03]
05-STL-Dateien-MK1-22-10-26/Filament-Guide (FG)/FG03.2-swing for 2.5kg spools (option).stl
67.8 x 166.9 x 7.00
