EdgarMata/MY-Filamente-Extruder/05-STL-Dateien-MK1-22-10-26/Filament-Guide (FG)/FG10.1-spiral axis for 1,75mm Part1.stl

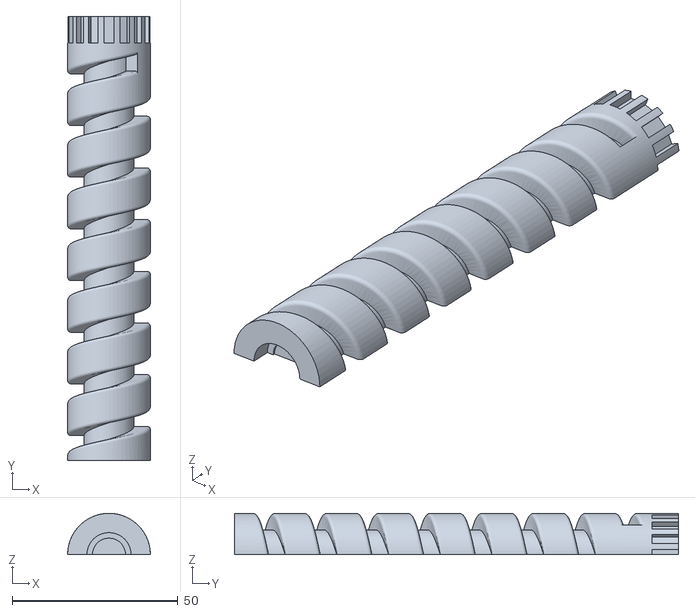
[picture p71: CAD file, 2024-07-03]
05-STL-Dateien-MK1-22-10-26/Filament-Guide (FG)/FG10.1-spiral axis for 1,75mm Part1.stl
25.0 x 134.0 x 12.5
