EdgarMata/MY-Filamente-Extruder/(list of files, cad)

Other CAD files:
05-STL-Dateien-MK1-22-10-26/Filament-Guide (FG)/FG10.4-spiral axis for 2,85mm Part2.stl
05-STL-Dateien-MK1-22-10-26/Filament-Guide (FG)/FG02-hook right.stl
